zenithistk/Horangi/README.md

# Horangi

The Horangi is a split ergonomic keyboard with a row-staggered and curved layout.

* [horangi](/horangi) - Reversible with integrated trackball
* [horangi_grin](/horangi_grin) - Fully wireless and grin layout
