zenithistk/Horangi/horangi_grin/README.md

# Horangi_grin

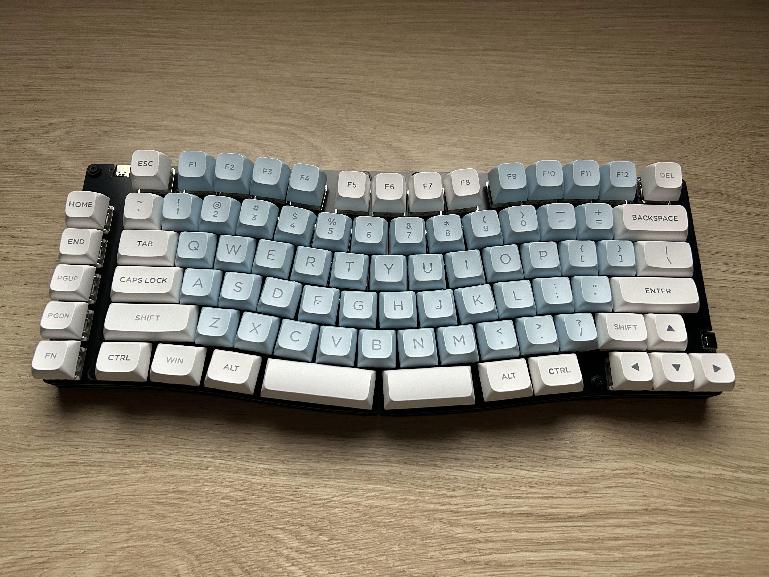
[picture p1: horangi_grin/images/horangi_grin_1.JPG]
horangi_grin_1

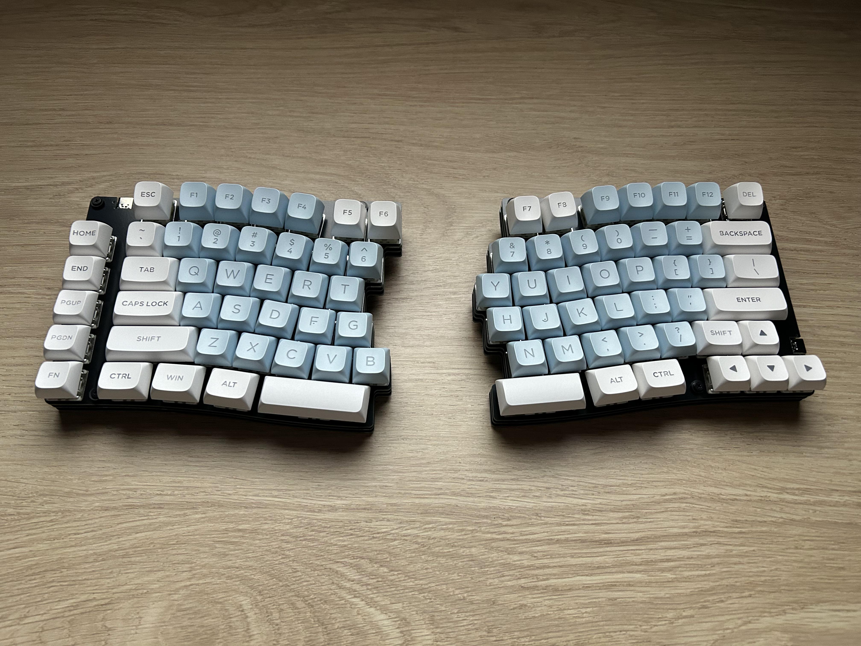
[picture p2: horangi_grin/images/horangi_grin_2.JPG]
horangi_grin_1


The 'Horangi_grin' keyboard is a fully wireless, ergonomic split keyboard. Inspired by the [Grin layout keyboard](https://kbd.news/Grin-layout-1348.html), this keyboard features a layout similar to a 75% keyboard, making it easy for users accustomed to standard keyboards to adapt to a split keyboard. It can be used separately for each hand or combined as needed, and is designed to be as compact as possible, ensuring both practicality and portability.

* 83-key keyboard, grin layout
* XIAO ble MCU
* Fully wireless
* Hot-swap

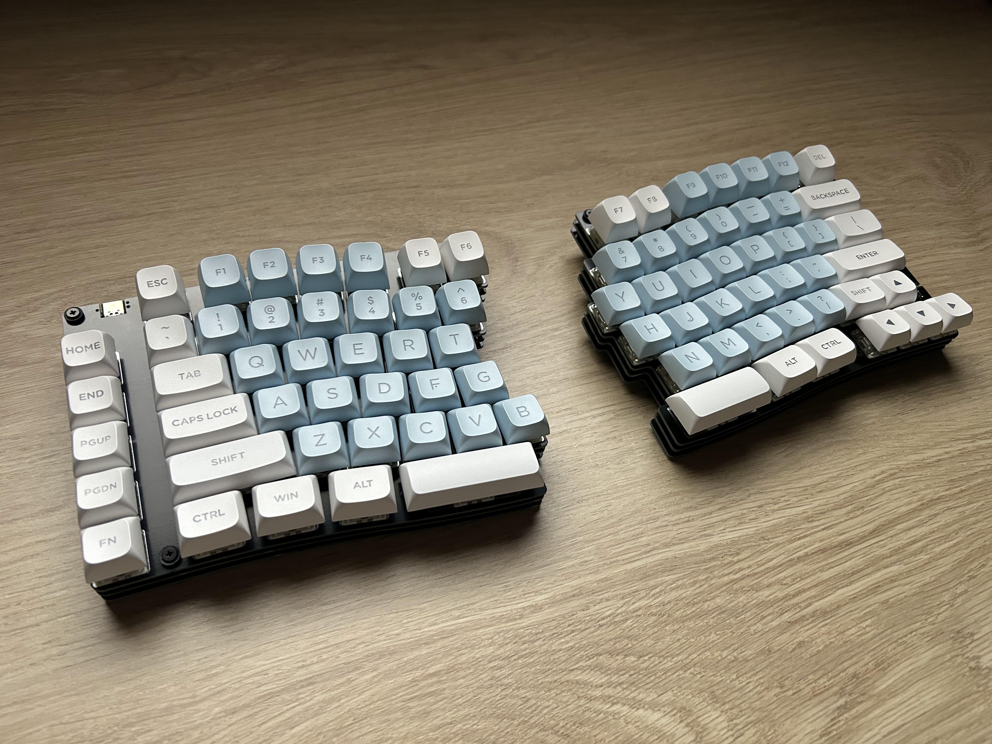
[picture p3: horangi_grin/images/horangi_grin_3.JPG]
horangi_grin_3

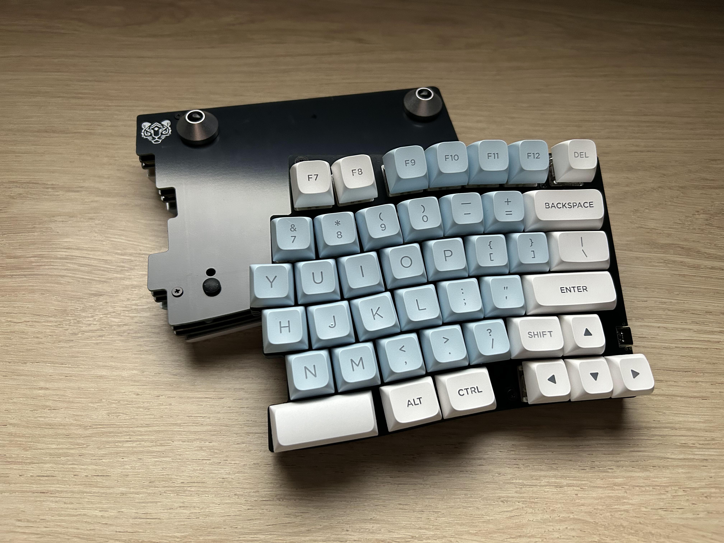
[picture p4: horangi_grin/images/horangi_grin_4.JPG]
horangi_grin_4


## Build Guide (WIP)
* [Build Guide](BUILDGUIDE.md)

## Firmware
Only zmk firmware is available.
* [zmk firmware](firmware)
* [source code](https://github.com/zenithistk/zmk-config-horangi_grin)
