zenithistk/Horangi/horangi_grin/pcb/Keebio-Parts.pretty-master/3dmodels/CUI_SJ-43614-SMT-TR.step

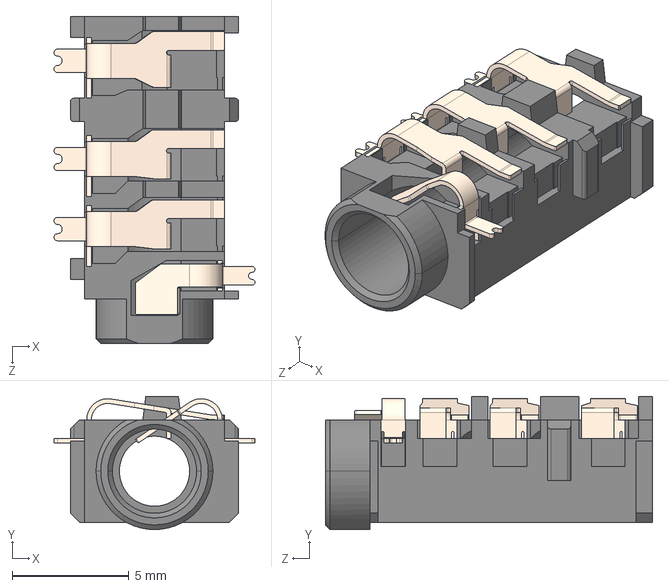
[picture p5: CAD file, 2023-12-28]
horangi_grin/pcb/Keebio-Parts.pretty-master/3dmodels/CUI_SJ-43614-SMT-TR.step
8.60 x 5.70 x 14.0 mm
