zenithistk/Horangi/horangi_grin/pcb/Keebio-Parts.pretty-master/3dmodels/HRO  TYPE-C-31-M-12.step

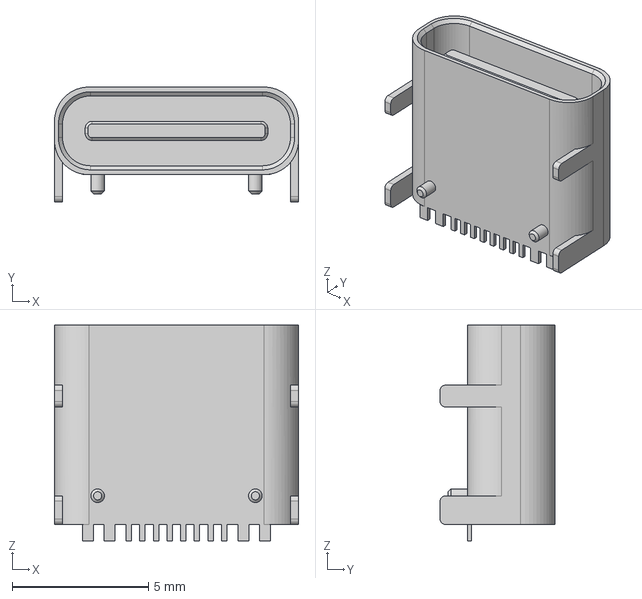
[picture p6: CAD file, 2023-12-28]
horangi_grin/pcb/Keebio-Parts.pretty-master/3dmodels/HRO TYPE-C-31-M-12.step
8.94 x 4.21 x 7.90 mm
