zenithistk/Horangi/horangi_grin/pcb/Keebio-Parts.pretty-master/3dmodels/PJ-320A.step

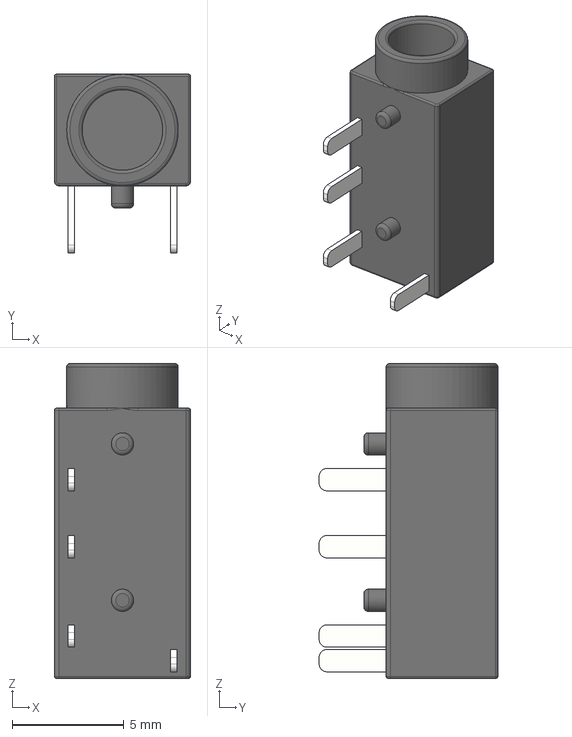
[picture p7: CAD file, 2023-12-28]
horangi_grin/pcb/Keebio-Parts.pretty-master/3dmodels/PJ-320A.step
6.10 x 8.00 x 14.1 mm
