zenithistk/Horangi/horangi_grin/pcb/Keebio-Parts.pretty-master/3dmodels/SK6812MINI-E v1.step

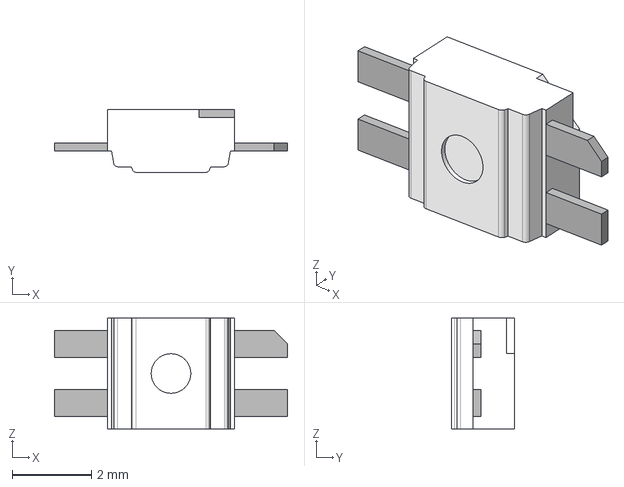
[picture p8: CAD file, 2023-12-28]
horangi_grin/pcb/Keebio-Parts.pretty-master/3dmodels/SK6812MINI-E v1.step
5.88 x 1.58 x 2.80 mm
