zenithistk/Horangi/horangi_grin/pcb/horangi_right.kicad_pcb

## KiCad design horangi_grin/pcb/horangi_right.kicad_pcb (2023-12-29)

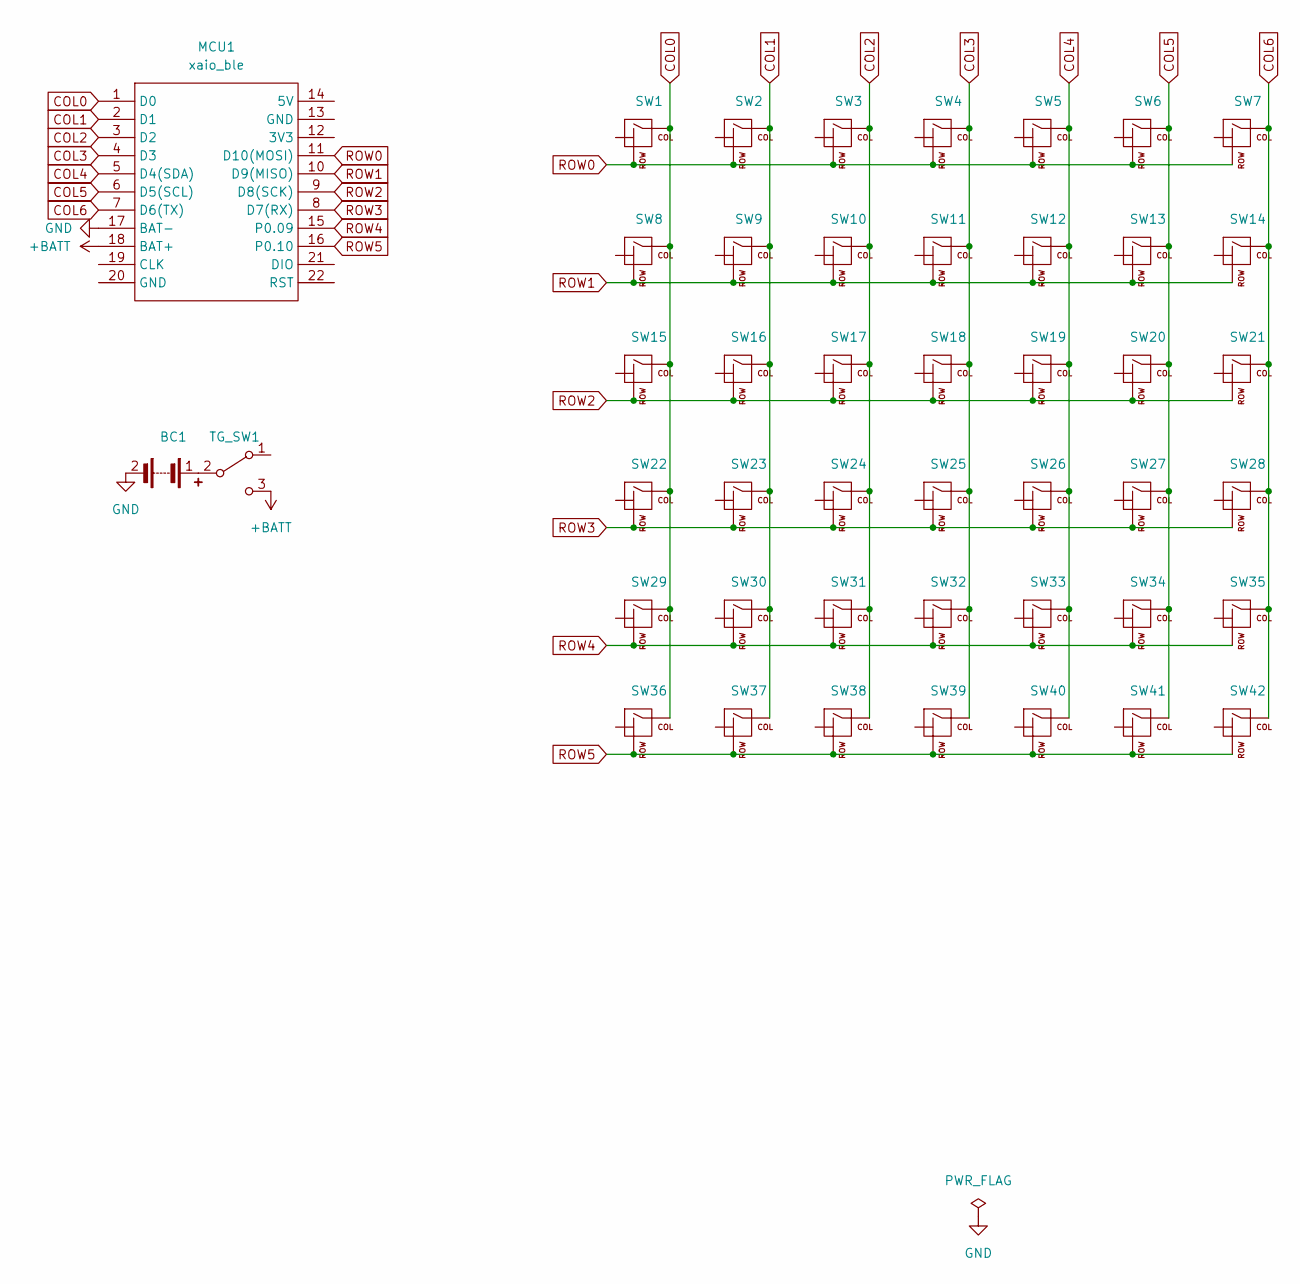
[picture p9: schematic horangi_right.kicad_sch]

Parts:
BC1: Battery_Connector; battery_1.25mm_jst
MCU1: xaio_ble; Seeeduino XIAO-MOUDLE14P-2.54-21X17.8MM
SW1, SW2, SW3, SW4, SW5, SW6, SW7, SW8, SW9, SW10, SW11, SW12, SW13, SW14, SW15, SW16, SW17, SW18, SW19, SW20, SW21, SW22, SW23, SW24, SW25, SW26, SW27, SW28, SW29, SW30, SW31, SW32, SW33, SW34, SW35, SW36, SW37, SW38, SW39, SW40, SW41, SW42: Switch; MX-hotswap-diode-smd
TG_SW1: Toggle_Switch; SK19 toggle switch

Connections:
+BATT: MCU1.18 (BAT+), TG_SW1.3
COL0: MCU1.1 (D0), SW1.1 (COL), SW8.1 (COL), SW15.1 (COL), SW22.1 (COL), SW29.1 (COL), SW36.1 (COL)
COL1: MCU1.2 (D1), SW2.1 (COL), SW9.1 (COL), SW16.1 (COL), SW23.1 (COL), SW30.1 (COL), SW37.1 (COL)
COL2: MCU1.3 (D2), SW3.1 (COL), SW10.1 (COL), SW17.1 (COL), SW24.1 (COL), SW31.1 (COL), SW38.1 (COL)
COL3: MCU1.4 (D3), SW4.1 (COL), SW11.1 (COL), SW18.1 (COL), SW25.1 (COL), SW32.1 (COL), SW39.1 (COL)
COL4: MCU1.5 (D4(SDA)), SW5.1 (COL), SW12.1 (COL), SW19.1 (COL), SW26.1 (COL), SW33.1 (COL), SW40.1 (COL)
COL5: MCU1.6 (D5(SCL)), SW6.1 (COL), SW13.1 (COL), SW20.1 (COL), SW27.1 (COL), SW34.1 (COL), SW41.1 (COL)
COL6: MCU1.7 (D6(TX)), SW7.1 (COL), SW14.1 (COL), SW21.1 (COL), SW28.1 (COL), SW35.1 (COL), SW42.1 (COL)
GND: BC1.2, MCU1.17 (BAT-)
unnamed: BC1.1, TG_SW1.2
ROW0: MCU1.11 (D10(MOSI)), SW1.2 (ROW), SW2.2 (ROW), SW3.2 (ROW), SW4.2 (ROW), SW5.2 (ROW), SW6.2 (ROW), SW7.2 (ROW)
ROW1: MCU1.10 (D9(MISO)), SW8.2 (ROW), SW9.2 (ROW), SW10.2 (ROW), SW11.2 (ROW), SW12.2 (ROW), SW13.2 (ROW), SW14.2 (ROW)
ROW2: MCU1.9 (D8(SCK)), SW15.2 (ROW), SW16.2 (ROW), SW17.2 (ROW), SW18.2 (ROW), SW19.2 (ROW), SW20.2 (ROW), SW21.2 (ROW)
ROW3: MCU1.8 (D7(RX)), SW22.2 (ROW), SW23.2 (ROW), SW24.2 (ROW), SW25.2 (ROW), SW26.2 (ROW), SW27.2 (ROW), SW28.2 (ROW)
ROW4: MCU1.15 (P0.09), SW29.2 (ROW), SW30.2 (ROW), SW31.2 (ROW), SW32.2 (ROW), SW33.2 (ROW), SW34.2 (ROW), SW35.2 (ROW)
ROW5: MCU1.16 (P0.10), SW36.2 (ROW), SW37.2 (ROW), SW38.2 (ROW), SW39.2 (ROW), SW40.2 (ROW), SW41.2 (ROW), SW42.2 (ROW)

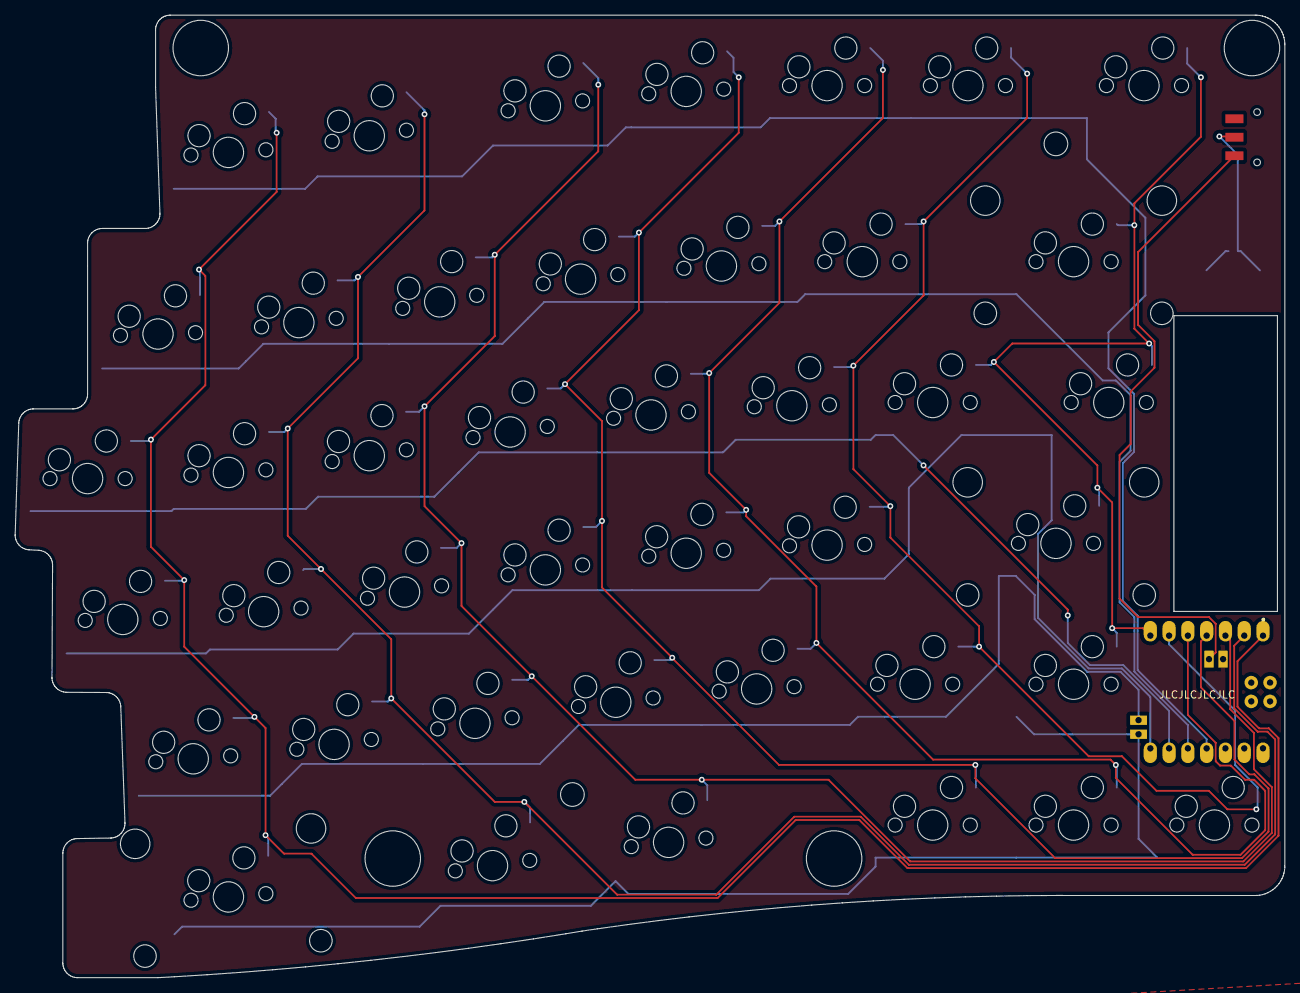
[picture p10: board horangi_right.kicad_pcb from above]

Board: 2 copper layers, 171.7 x 130.2 mm, 45 parts (0 on the bottom side), 16 nets.
