zenithistk/Horangi/horangi_grin/pcb/horangi_right_plate.kicad_pcb

## KiCad design horangi_grin/pcb/horangi_right_plate.kicad_pcb (2023-12-28)

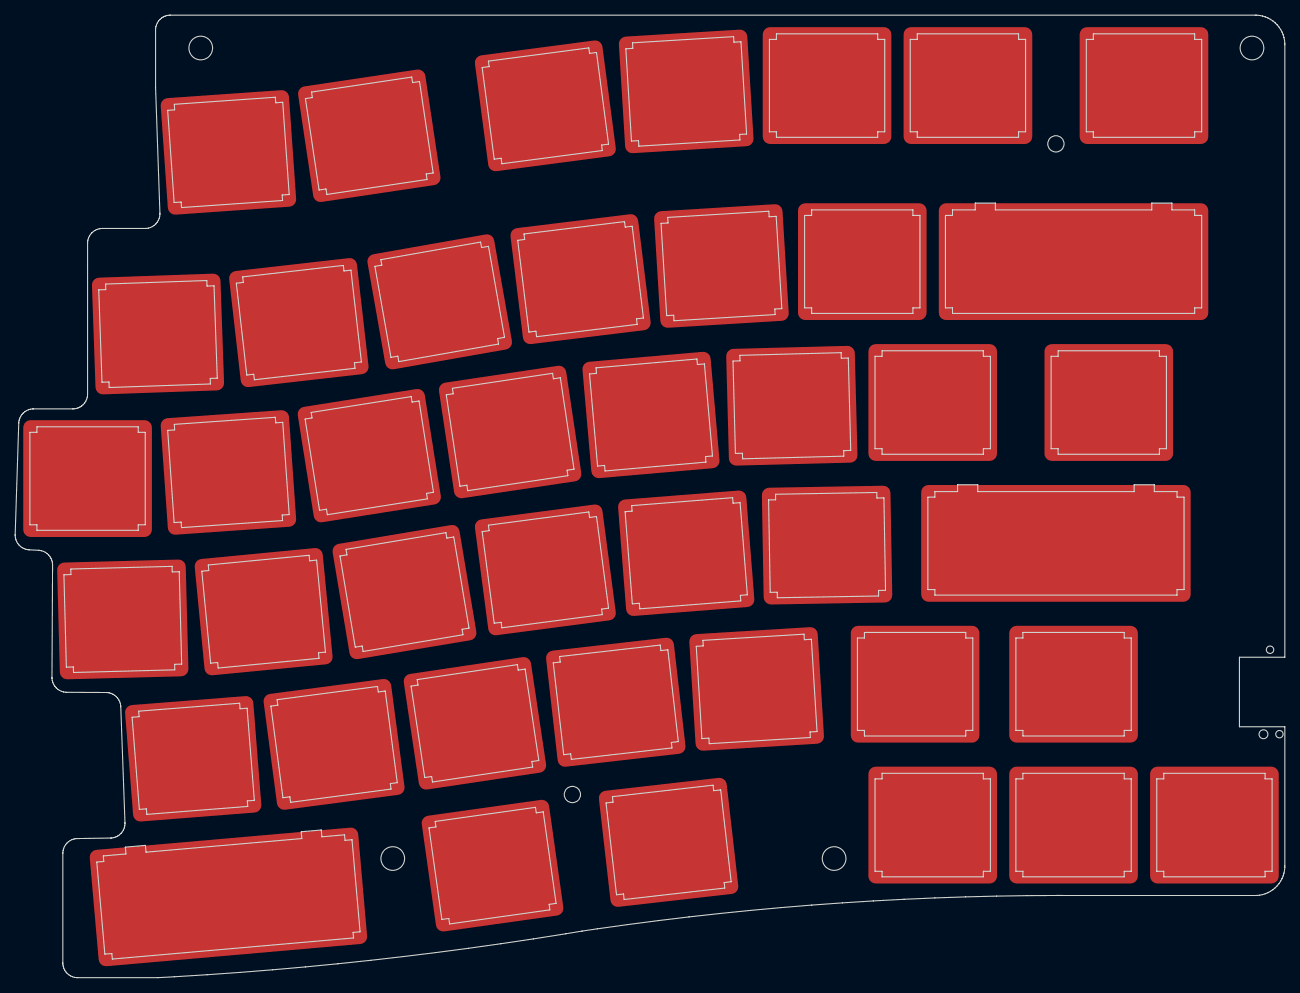
[picture p11: board horangi_right_plate.kicad_pcb from above]

Board: 2 copper layers, 171.7 x 130.2 mm, 42 parts (0 on the bottom side), 7 nets, no tracks yet.

Parts:
SW1, SW2, SW3, SW4, SW5, SW6, SW7, SW8, SW9, SW10, SW11, SW12, SW13, SW15, SW16, SW17, SW18, SW19, SW20, SW21, SW22, SW23, SW24, SW25, SW26, SW27, SW28, SW29, SW30, SW31, SW32, SW33, SW34, SW37, SW38, SW39, SW40, SW41, SW42: Switch; MX-Alps_Switch_Cutout
SW14, SW35, SW36: Switch; MX-Alps_Switch_Cutout-1u_2u

Connections:
COL0: SW1.1 (COL), SW8.1 (COL), SW15.1 (COL), SW22.1 (COL), SW29.1 (COL), SW36.1 (COL)
COL1: SW2.1 (COL), SW9.1 (COL), SW16.1 (COL), SW23.1 (COL), SW30.1 (COL), SW37.1 (COL)
COL2: SW3.1 (COL), SW10.1 (COL), SW17.1 (COL), SW24.1 (COL), SW31.1 (COL), SW38.1 (COL)
COL3: SW4.1 (COL), SW11.1 (COL), SW18.1 (COL), SW25.1 (COL), SW32.1 (COL), SW39.1 (COL)
COL4: SW5.1 (COL), SW12.1 (COL), SW19.1 (COL), SW26.1 (COL), SW33.1 (COL), SW40.1 (COL)
COL5: SW6.1 (COL), SW13.1 (COL), SW20.1 (COL), SW27.1 (COL), SW34.1 (COL), SW41.1 (COL)
COL6: SW7.1 (COL), SW14.1 (COL), SW21.1 (COL), SW28.1 (COL), SW35.1 (COL), SW42.1 (COL)
