zenithistk/Horangi/horangi/pcb/main/horangi.kicad_pcb

## KiCad design horangi/pcb/main/horangi.kicad_pcb (2023-12-27)

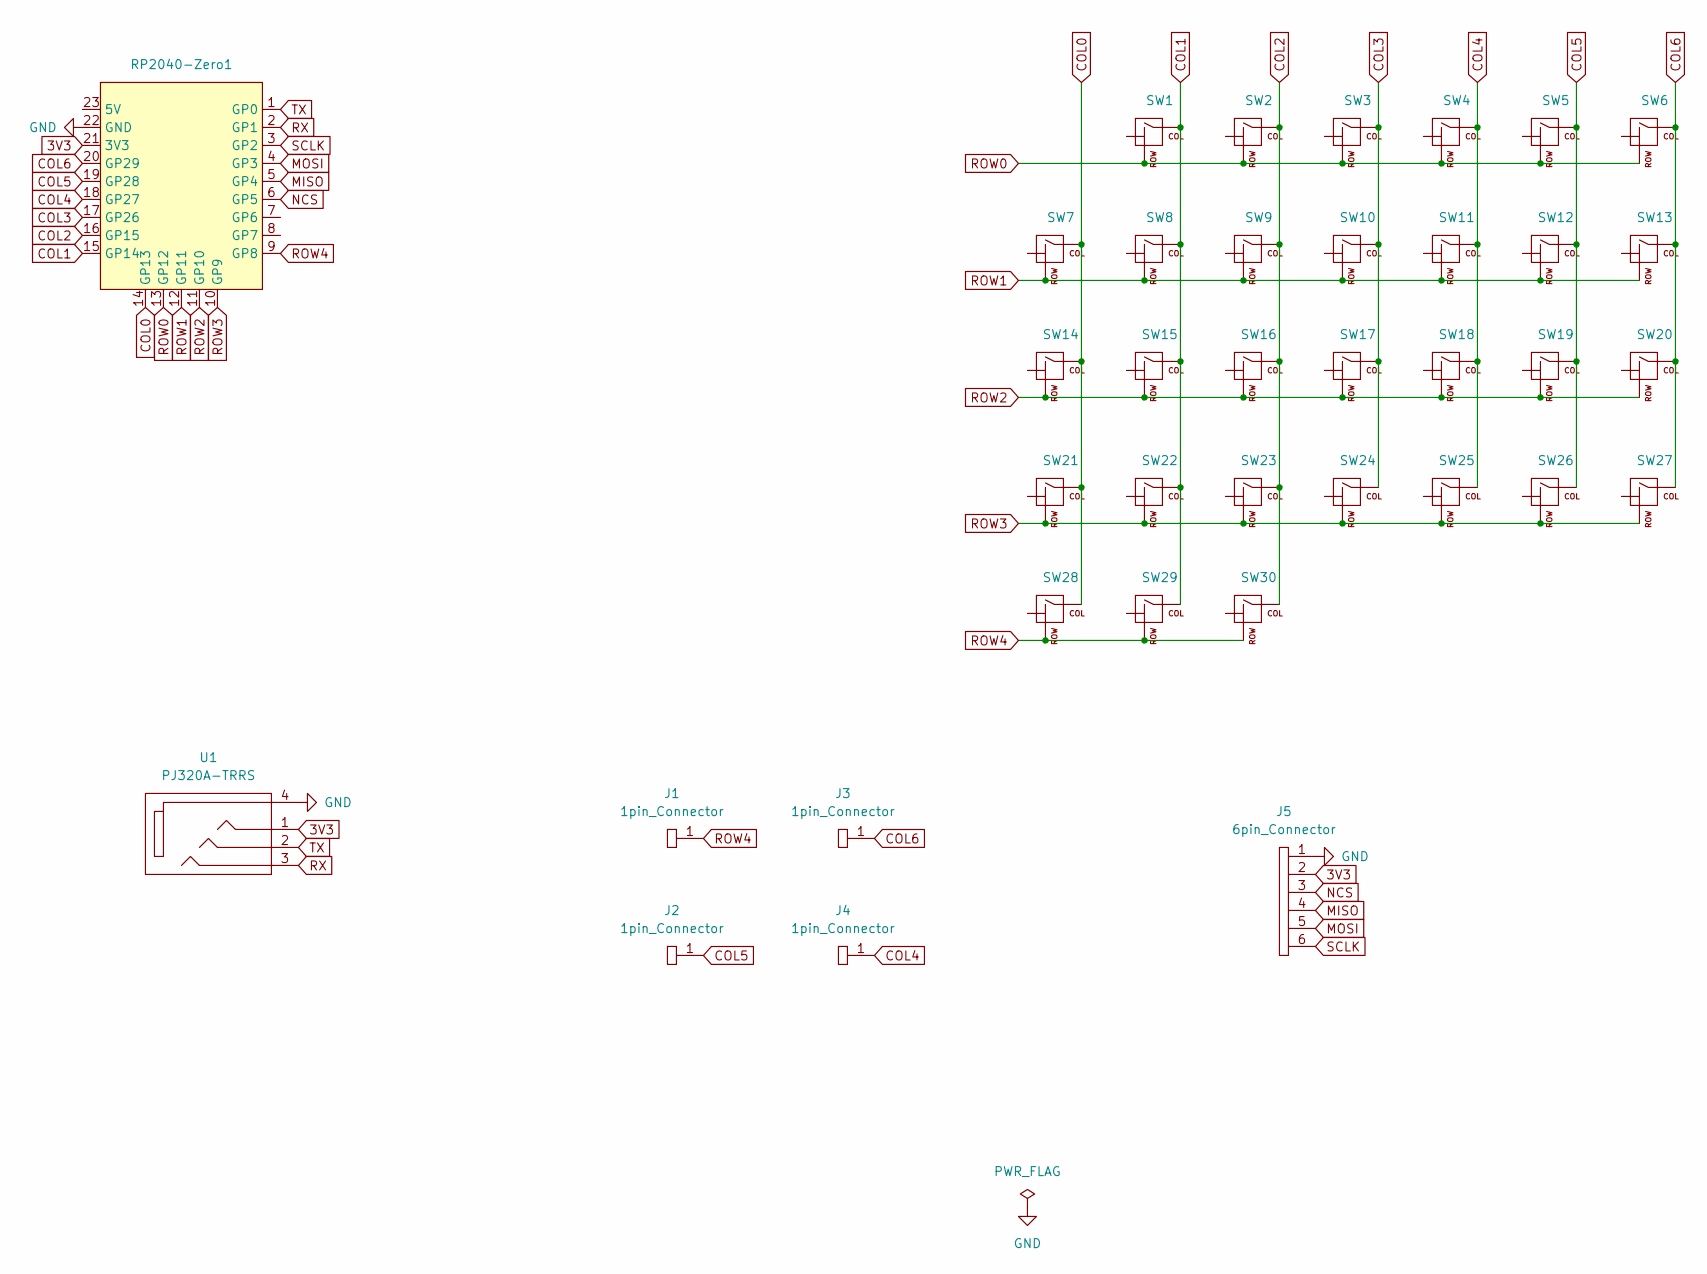
[picture p12: schematic horangi.kicad_sch]

Parts:
J1, J2, J3, J4: 1pin_Connector; 1pin_connector
J5: 6pin_Connector; 6pin_connector
RP2040-Zero1: RP2040-Zero
SW1, SW2, SW3, SW4, SW5, SW6, SW7, SW8, SW9, SW10, SW11, SW12, SW13, SW14, SW15, SW16, SW17, SW18, SW19, SW20, SW21, SW22, SW23, SW24, SW25, SW26, SW27, SW28, SW29, SW30: Switch; ks33-hotswap-diode-smd_1u
U1: PJ320A-TRRS; PJ320A-TRRS_reversable

Connections:
3V3: J5.2, RP2040-Zero1.21 (3V3), U1.1
COL0: RP2040-Zero1.14 (GP13), SW7.1 (COL), SW14.1 (COL), SW21.1 (COL), SW28.1 (COL)
COL1: RP2040-Zero1.15 (GP14), SW1.1 (COL), SW8.1 (COL), SW15.1 (COL), SW22.1 (COL), SW29.1 (COL)
COL2: RP2040-Zero1.16 (GP15), SW2.1 (COL), SW9.1 (COL), SW16.1 (COL), SW23.1 (COL), SW30.1 (COL)
COL3: RP2040-Zero1.17 (GP26), SW3.1 (COL), SW10.1 (COL), SW17.1 (COL), SW24.1 (COL)
COL4: J4.1, RP2040-Zero1.18 (GP27), SW4.1 (COL), SW11.1 (COL), SW18.1 (COL), SW25.1 (COL)
COL5: J2.1, RP2040-Zero1.19 (GP28), SW5.1 (COL), SW12.1 (COL), SW19.1 (COL), SW26.1 (COL)
COL6: J3.1, RP2040-Zero1.20 (GP29), SW6.1 (COL), SW13.1 (COL), SW20.1 (COL), SW27.1 (COL)
GND: J5.1, RP2040-Zero1.22 (GND), U1.4
MISO: J5.4, RP2040-Zero1.5 (GP4)
MOSI: J5.5, RP2040-Zero1.4 (GP3)
NCS: J5.3, RP2040-Zero1.6 (GP5)
ROW0: RP2040-Zero1.13 (GP12), SW1.2 (ROW), SW2.2 (ROW), SW3.2 (ROW), SW4.2 (ROW), SW5.2 (ROW), SW6.2 (ROW)
ROW1: RP2040-Zero1.12 (GP11), SW7.2 (ROW), SW8.2 (ROW), SW9.2 (ROW), SW10.2 (ROW), SW11.2 (ROW), SW12.2 (ROW), SW13.2 (ROW)
ROW2: RP2040-Zero1.11 (GP10), SW14.2 (ROW), SW15.2 (ROW), SW16.2 (ROW), SW17.2 (ROW), SW18.2 (ROW), SW19.2 (ROW), SW20.2 (ROW)
ROW3: RP2040-Zero1.10 (GP9), SW21.2 (ROW), SW22.2 (ROW), SW23.2 (ROW), SW24.2 (ROW), SW25.2 (ROW), SW26.2 (ROW), SW27.2 (ROW)
ROW4: J1.1, RP2040-Zero1.9 (GP8), SW28.2 (ROW), SW29.2 (ROW), SW30.2 (ROW)
RX: RP2040-Zero1.2 (GP1), U1.3
SCLK: J5.6, RP2040-Zero1.3 (GP2)
TX: RP2040-Zero1.1 (GP0), U1.2

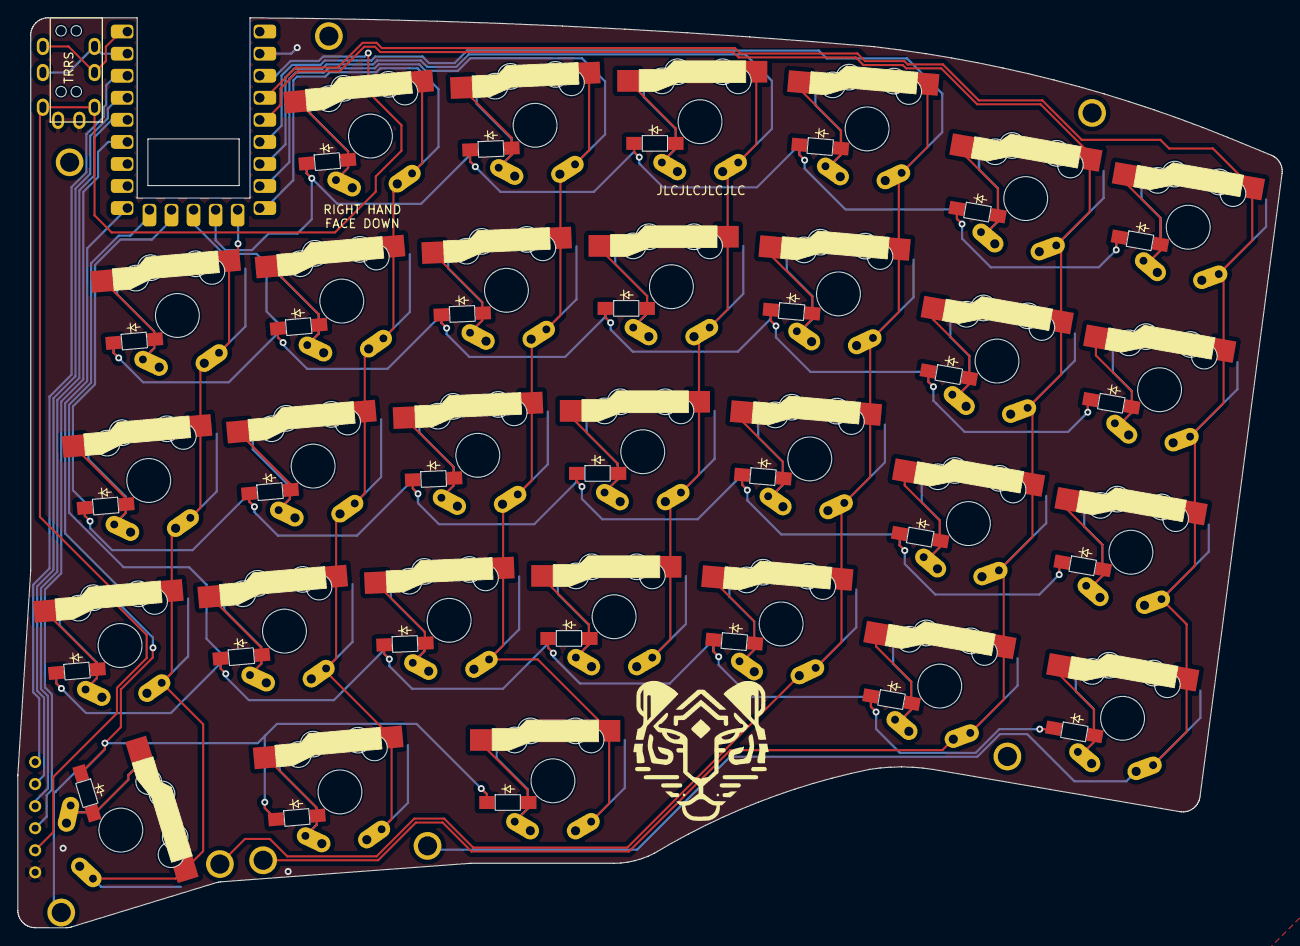
[picture p13: board horangi.kicad_pcb from above]

Board: 2 copper layers, 145.6 x 104.8 mm, 41 parts (1 on the bottom side), 20 nets.

Other parts of the board:
TH1, TH1#2, TH1#3, TH1#4: HOLE; HOLE_M2
