zenithistk/Horangi/horangi/pcb/main/horangi_thumb.kicad_pcb

## KiCad design horangi/pcb/main/horangi_thumb.kicad_pcb (2023-12-27)

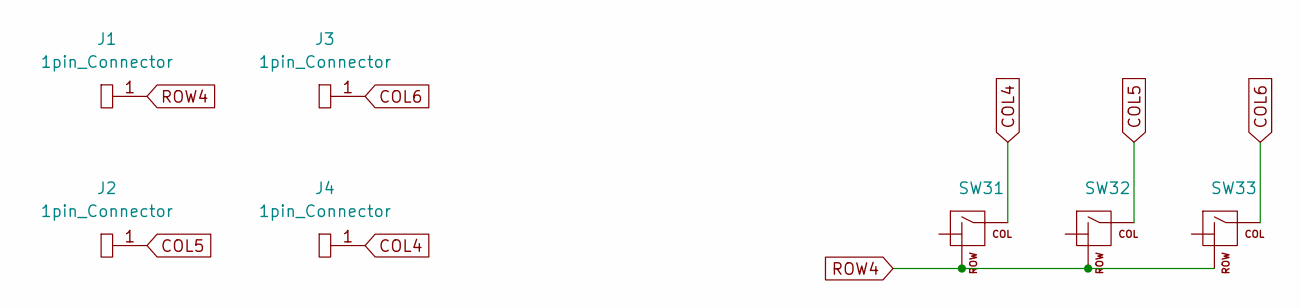
[picture p14: schematic horangi_thumb.kicad_sch]

Parts:
J1, J2, J3, J4: 1pin_Connector; 1pin_connector
SW31, SW32, SW33: Switch; ks33-hotswap-diode-smd_1u

Connections:
COL4: J4.1, SW31.1 (COL)
COL5: J2.1, SW32.1 (COL)
COL6: J3.1, SW33.1 (COL)
ROW4: J1.1, SW31.2 (ROW), SW32.2 (ROW), SW33.2 (ROW)

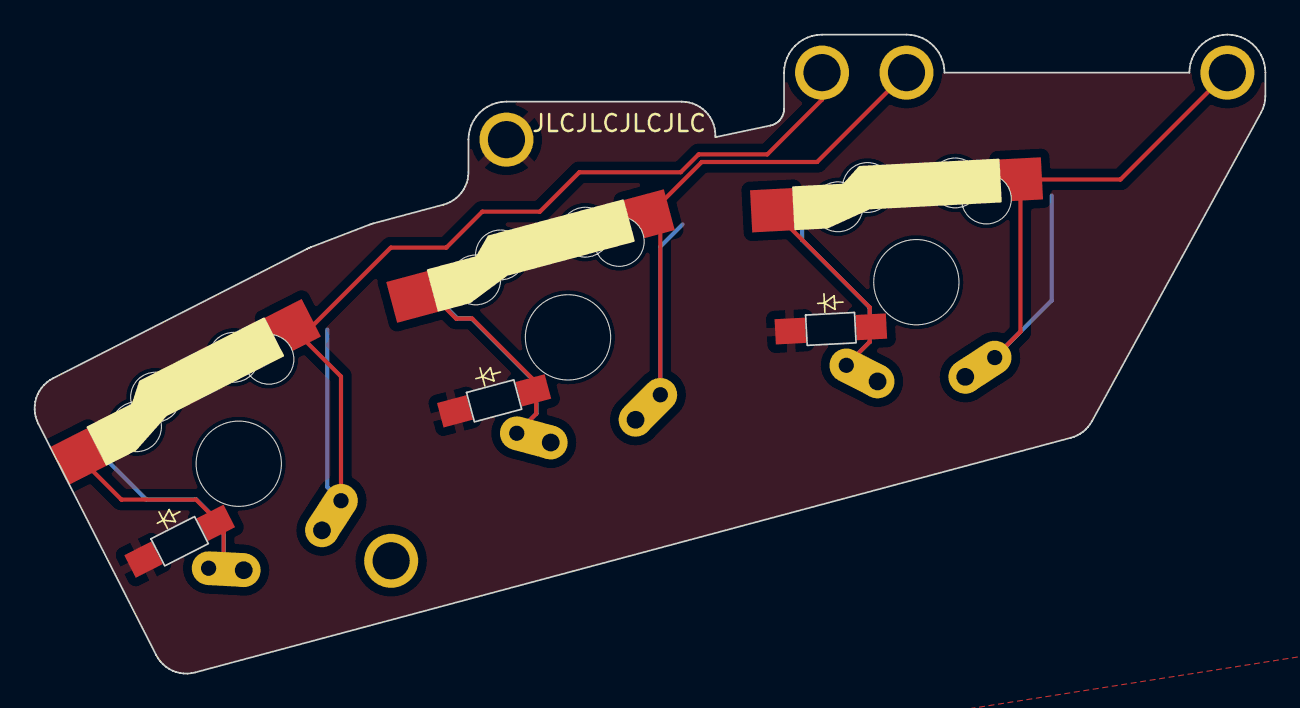
[picture p15: board horangi_thumb.kicad_pcb from above]

Board: 2 copper layers, 72.9 x 37.8 mm, 7 parts (0 on the bottom side), 4 nets.
