zenithistk/Horangi/horangi/BUILDGUIDE.md

## Bills of materials

| Part | Type | Amount | Cost | Link |
| :---| :--- | :----- | :---| :--- |
| PCB | Main | 2 | $1.94 each[^1] | [Gerber](https://github.com/zenithistk/Horangi/tree/main/horangi/GERBER) |
| PCB | Thumb cluster | 2 | $0.4 each[^2] | [Gerber](https://github.com/zenithistk/Horangi/tree/main/horangi/GERBER) |
| MCU | rp2040-zero | 2 | $3.35 each | [Aliexpress](https://www.aliprice.com/s?id=1005003823256706_18&u=&c=sYrnLeA6cygvL8dYFBu0WWWhFu&mv=3) |
| Diodes | SOD-123 1N4148 | 66 | $1.5 | [Aliexpress](https://www.aliprice.com/s?id=4000685043735_18&u=&c=sYrnLeA6cygvL8dYFBu0WWWhFu&mv=3) |
| TRRS Jack | PJ-320A | 2 | $1.5 | [Aliexpress](https://www.aliprice.com/s?id=4000661212458_18&u=&c=sYrnLeA6cygvL8dYFBu0WWWhFu&mv=3) |
| Switches | Gateron KS-33 | 66 | $23 | [Aliexpress](https://www.aliprice.com/s?id=1005005929430704_18&u=&c=sYrnLeA6cygvL8dYFBu0WWWhFu&mv=3) |
| Hot swap socket | | 66 | $15 | [Aliexpress](https://www.aliprice.com/s?id=1005004128409069_18&u=&c=sYrnLeA6cygvL8dYFBu0WWWhFu&mv=3) |
| TRRS Cable | | 1 | $2 | [Aliexpress](https://www.aliprice.com/s?id=1005003415667083_18&u=&c=sYrnLeA6cygvL8dYFBu0WWWhFu&mv=3) |
| M2 Standoff Spacer | female-female, 12mm | 2 | $0.04 each | [Aliexpress](https://www.aliprice.com/s?id=4001271908929_18&u=&c=sYrnLeA6cygvL8dYFBu0WWWhFu&mv=3) |
| M2 Standoff Spacer | female-female, 9mm  | 2 | $0.04 each | [Aliexpress](https://www.aliprice.com/s?id=4001271908929_18&u=&c=sYrnLeA6cygvL8dYFBu0WWWhFu&mv=3) |
| M2 Screw | 8mm | 12 | $0.03 each | [Aliexpress](https://www.aliprice.com/s?id=4001248931159_18&u=&c=sYrnLeA6cygvL8dYFBu0WWWhFu&mv=3) |
| M2 Nut | | 16 | $0.03 each | [Aliexpress](https://www.aliprice.com/s?id=32977174437_18&u=&c=sYrnLeA6cygvL8dYFBu0WWWhFu&mv=3) |
| Silicone Rubber Round End Cap | 2.8mm | 4 | $0.01 each | [Aliexpress](https://www.aliprice.com/s?id=1005005181061897_18&u=&c=GzElGWnvfnh7JDjLFWhKuwBwuH&mv=3) |
| Silicone Rubber Bumper  | 8mmx2mm | 4 | $0.02 each | [Aliexpress](https://www.aliprice.com/s?id=1005004068119765_18&u=&c=GzElGWnvfnh7JDjLFWhKuwBwuH&mv=3) |

### Optional(trackball)

## Build Guide (WIP)

[^1]: When printing at JLCPCB, it costs $9.7 based on the minimum order quantity of 5 sheets, so the price per piece is approximately $1.94.
[^2]: When printing at JLCPCB, it costs $2 based on the minimum order quantity of 5 sheets, so the price per piece is approximately $0.4.
