zenithistk/Horangi/horangi_grin/BUILDGUIDE.md

## Bills of materials

| Part | Type | Amount | Cost | Link |
| :---| :--- | :----- | :---| :--- |
| PCB | left, right | 1 each | $2.48 each[^1] | [Gerber](https://github.com/zenithistk/Horangi/tree/main/horangi_grin/GERBER) |
| Plate | left, right | 1 each | $2.48 each | [Gerber](https://github.com/zenithistk/Horangi/tree/main/horangi_grin/GERBER) |
| Bottom | left, right | 1 each | $2.48 each | [Gerber](https://github.com/zenithistk/Horangi/tree/main/horangi_grin/GERBER) |
| MCU | XIAO BLE | 2 | $23.5 | [Aliexpress](https://www.aliprice.com/s?id=1005004459618789_18&u=&c=STk20aIrxybL5QZVFBu0hwKupp&mv=3) |
| Diodes | SOD-123 1N4148 | 83 | $1.5 | [Aliexpress](https://www.aliprice.com/s?id=4000685043735_18&u=&c=sYrnLeA6cygvL8dYFBu0WWWhFu&mv=3) |
| Switches | MX Switch | 83 | | |
| Hot swap socket | 1511 for MX Switch | 83 | $12 | [Aliexpress](https://www.aliprice.com/s?id=1005003873653184_18&u=&c=STk20aIrxybL5QZVFBu0hwKupp&mv=3) |
| PCB mount screw in Stabilizer | 104 x1 Set | 1 | $13 | [Aliexpress](https://www.aliprice.com/s?id=1005004322149134_18&u=&c=STk20aIrxybL5QZVFBu0hwKupp&mv=3) |
| M2 Standoff Spacer | female-female, 14mm | 8 | $0.04 each | [Aliexpress](https://www.aliprice.com/s?id=4001271908929_18&u=&c=sYrnLeA6cygvL8dYFBu0WWWhFu&mv=3) |
| ABS hollow spacer | ID4.2x OD.7, length 8mm | 8 | $1 | [Aliexpress](https://www.aliprice.com/s?id=1005004322149134_18&u=&c=STk20aIrxybL5QZVFBu0hwKupp&mv=3) |
| Plastic Rubber Flat Washer | 3x7mm, height 1.5mm | 24 | $1 | [Aliexpress](https://www.aliprice.com/s?id=1005001930481059_18&u=&c=STk20aIrxybL5QZVFBu0hwKupp&mv=3) |
| M2 Screw | 4mm | 16 | $0.03 each | [Aliexpress](https://www.aliprice.com/s?id=1005005275692984_18&u=&c=STk20aIrxybL5QZVFBu0hwKupp&mv=3) |
| Silicone Rubber Bumper  | 8mmx2mm | 4 | $0.02 each | [Aliexpress](https://www.aliprice.com/s?id=1005004068119765_18&u=&c=GzElGWnvfnh7JDjLFWhKuwBwuH&mv=3) |
| Mechanical keyboard aluminum cone feet |  | 2pcs*2 | $9 | [Aliexpress](https://www.aliprice.com/s?id=1005003651105955_18&u=&c=STk20aIrxybL5QZVFBu0hwKupp&mv=3) |

It costs about $120 total including keycaps.

## Build Guide (WIP)

[^1]: When printing at JLCPCB, it costs $12.4 based on the minimum order quantity of 5 sheets, so the price per piece is approximately $2.48.
