zenithistk/Horangi/(commit log)

2023-12-27 upload horangi keyboard
    [horangi.kicad_pcb, horangi.kicad_sch, horangi_thumb.kicad_pcb, horangi_thumb.kicad_sch]
2023-12-28 upload horangi_grin
    [CUI_SJ-43614-SMT-TR.step, HRO TYPE-C-31-M-12.step, PJ-320A.step, SK6812MINI-E v1.step, horangi_left.kicad_pcb, horangi_left.kicad_sch, horangi_left_bottom.kicad_pcb, horangi_left_bottom.kicad_sch]
2023-12-29 update horangi
    [horangi_left.kicad_pcb, horangi_right.kicad_pcb]
